phorton1/Arduino-_esp32-ideaspark_problem/docs/images/ssd1306_schematic.jpg

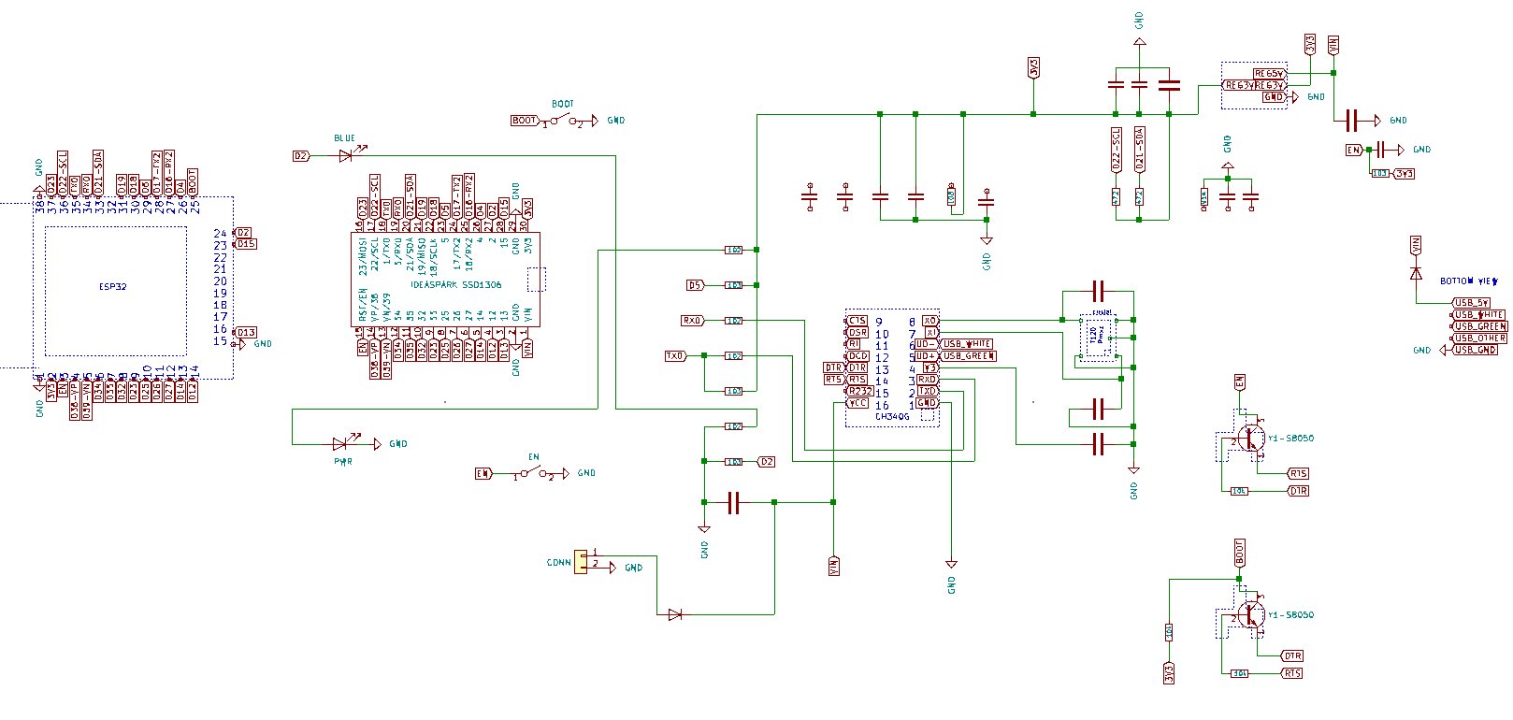
docs/images/ssd1306_schematic.jpg
