phorton1/Arduino-_esp32-ideaspark_problem/docs/images/st7789_schematic.jpg

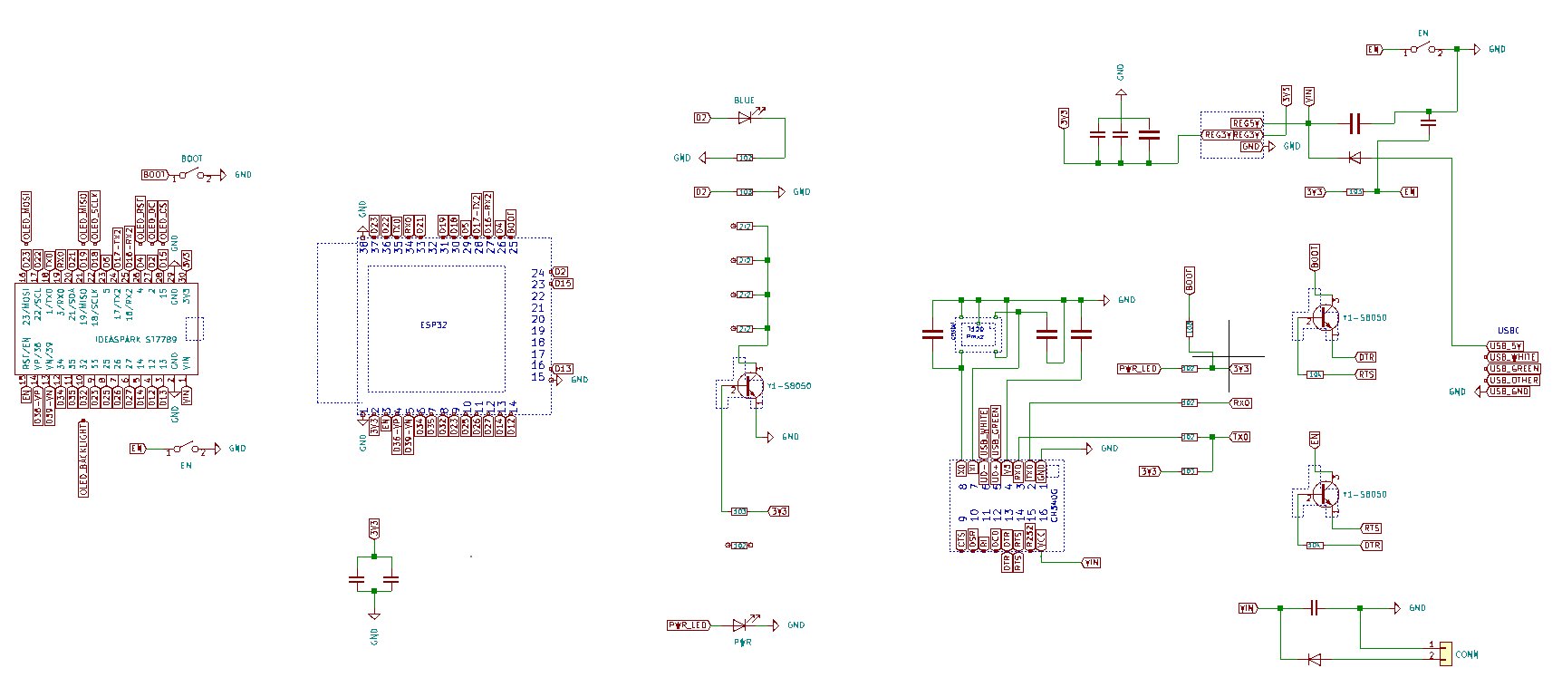
docs/images/st7789_schematic.jpg
