phorton1/Arduino-_esp32-ideaspark_problem/docs/images/ssd1306_fix_big.jpg

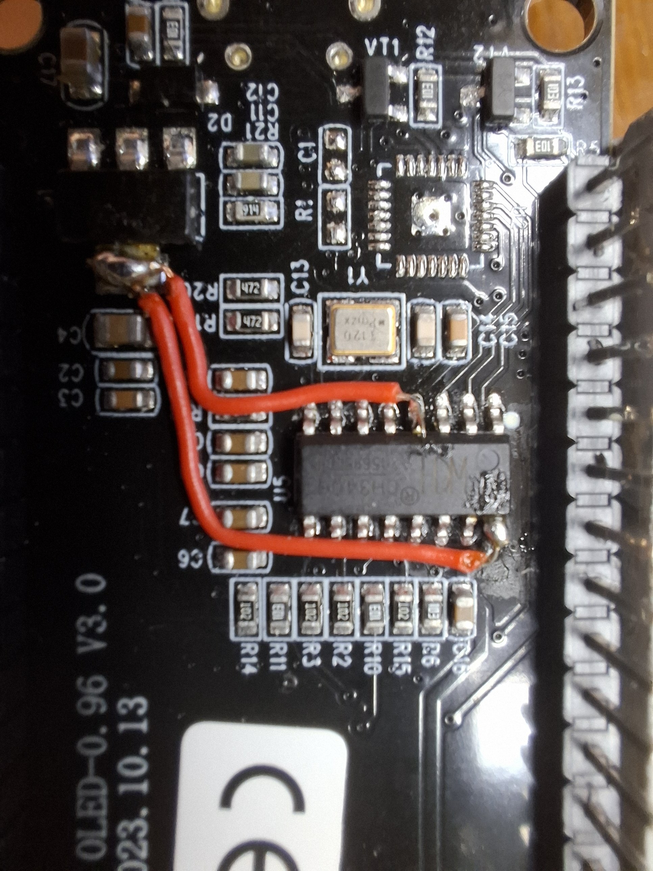
docs/images/ssd1306_fix_big.jpg
